Tharun-Reddy777/GDSReady-RV/docs/GDSReady_RV_Final_Project_Report.docx

GDSReady-RV

RTL-to-GDSII Implementation of a 32-bit 5-Stage Pipelined RISC-V Processor

Final Project Report
ASIC implementation using LibreLane and the SKY130 HD standard-cell flow

Design | riscv_core_asic
Architecture | 32-bit, 5-stage pipelined RISC-V
Pipeline | IF → ID → EX → MEM → WB
Clock target | 10.0 ns (100 MHz)
Final physical run | RISCV_ASIC_PNR_01

# 1. Abstract

This project implements a 32-bit RISC-V-style processor as a complete RTL-to-GDSII flow. The processor uses a five-stage IF/ID/EX/MEM/WB pipeline, a 32-entry register file, an ALU supporting the required arithmetic and logical operations, immediate generation, control and branch logic, forwarding, load-use hazard detection, instruction/data memory for RTL verification, and an ASIC-facing memory interface for physical implementation. The RTL was verified using directed regression tests for ALU operations, forwarding, load/store behavior, load-use hazards, BEQ/BNE, and JAL. The ASIC-facing core was synthesized and taken through floorplanning, placement, clock-tree synthesis, routing, post-route timing, DRC, LVS, antenna checking, and GDSII generation.

# 2. Objectives

- Develop a synthesizable 32-bit RISC-V processor with a five-stage pipeline.
- Implement register-file, ALU, immediate, control, branch, forwarding, and hazard-management logic.
- Verify representative RV32I-style instruction and pipeline behaviors using simulation.
- Create an ASIC-facing top-level interface for instruction and data memory.
- Complete synthesis and physical implementation using LibreLane/OpenROAD and SKY130 HD standard cells.
- Generate measurable implementation results including area, utilization, timing, DRC, LVS, antenna, and GDSII evidence.

# 3. Architecture

The processor follows the five-stage pipeline specified for the project: Instruction Fetch (IF), Instruction Decode (ID), Execute (EX), Memory Access (MEM), and Write Back (WB). Pipeline registers separate the stages: IF/ID, ID/EX, EX/MEM, and MEM/WB.

- Program counter and instruction-fetch path
- Instruction decoder and control unit
- Immediate generator
- 32 × 32-bit register file with x0 hard-wired to zero
- ALU supporting ADD, SUB, AND, OR, XOR, SLT, SLL, SRL, and SRA
- Branch/jump target and decision logic
- Forwarding unit for EX/MEM and MEM/WB dependencies
- Hazard detection for load-use dependencies
- Instruction and data memory for RTL simulation
- ASIC-facing instruction/data memory ports

# 4. Pipeline and Hazard Handling

## 4.1 Forwarding

The forwarding unit provides EX/MEM-to-EX and MEM/WB-to-EX operand forwarding. This permits dependent arithmetic instructions to execute without unnecessary pipeline stalls.

## 4.2 Load-use hazard

A load followed immediately by an instruction consuming the loaded register is detected by the hazard unit. The verified regression demonstrates the required stall behavior.

## 4.3 Branch and jump handling

BEQ and BNE branch decisions are supported by the branch unit. JAL generates the jump target and writes PC+4 to the destination register. Both branch behavior and JAL were explicitly verified.

# 5. RTL Module Structure

- alu.s
- register_file.s
- program_counter.s
- immediate_generator.s
- instruction_decoder.s
- control_unit.s
- branch_unit.s
- forwarding_unit.s
- hazard_detection.s
- instruction_memory.s
- data_memory.s
- if_id_reg.s
- id_ex_reg.s
- ex_mem_reg.s
- mem_wb_reg.s
- riscv_core.s
- riscv_core_asic.s

# 6. RTL Verification

The final directed RTL regression completed successfully. The simulation produced only the expected $readmemh short-file warnings because the test programs contain fewer than the 256 initialized memory words; these warnings did not cause test failures.

Test | Key results | Purpose | Result | Evidence
ALU + forwarding | x1=5, x2=10, x3=15, x4=0xFFFFFFFB, x5=10 | RAW dependencies and ALU | PASS | final_regression_results.txt
Load/store + load-use | x3=1, x4=9, memory[2]=1 | Memory path and load-use stall | PASS | final_regression_results.txt
BEQ/BNE | x3=7, x6=9 | Taken/not-taken branch behavior | PASS | final_regression_results.txt
JAL | x1=4, x2=7, x3=5 | Jump target and PC+4 writeback | PASS | final_regression_results.txt

Final RTL regression result: ALL RTL REGRESSION TESTS PASSED.

# 7. ASIC-Oriented RTL Architecture

The initial RTL top-level used internal instruction/data memories. For ASIC implementation, an explicit riscv_core_asic top-level was introduced with instruction-memory and data-memory interfaces. This avoids relying on behavioral memory arrays as the physical-design boundary and produces a real standard-cell implementation with external memory ports.

# 8. RTL-to-GDSII Flow

1. RTL elaboration and synthesis with Yosys through LibreLane
2. Floorplanning and standard-cell row generation
3. Placement
4. Clock-tree synthesis
5. Global and detailed routing
6. Post-route static timing analysis
7. Antenna checking and repair
8. Magic DRC
9. KLayout DRC
10. Netgen LVS
11. Final GDSII stream-out

# 9. Synthesis Results

Metric | RISCV_ASIC_SYNTH_02
Mapped standard-cell instances | 7,070
Mapped instance area | 86,360.3264
Unmapped instances | 0
Inferred latches | 0
Synthesis check errors | 0
Lint errors | 0
Lint warnings | 2

The synthesis run produced a full ASIC-facing mapped netlist. The netlist contains memory interface ports and thousands of mapped standard-cell instances, unlike the earlier internal-memory top-level attempt that optimized away most of the processor logic.

# 10. Physical Implementation Results

Metric | RISCV_ASIC_PNR_01
Clock target | 10.0 ns / 100 MHz
Post-P&R utilization | 47.3588%
Post-P&R aggregate setup WNS | −7.232224 ns
Post-P&R aggregate setup TNS | −1688.802674 ns
Hold WNS | 0 ns
Hold TNS | 0 ns
Worst nom_ss post-P&R setup WNS | −6.861401 ns

The final physical implementation is not setup-timing-clean at the 10 ns target under the slow-corner analysis. The worst post-P&R nominal slow-corner setup WNS is −6.861401 ns at 100 °C and 1.60 V. Hold timing is clean in the reported corners. The negative setup slack is retained as an implementation result rather than being presented as timing closure.

# 11. Physical Verification

Check | Result | Evidence
OpenROAD detailed-routing DRC | PASS / no final violations | riscv_core_asic.drc
Magic DRC | PASS | drc.magic.rpt
KLayout DRC | PASS; total = 0 | drc.klayout.json
Netgen LVS | PASS; circuits match uniquely | lvs.netgen.rpt
Antenna | PASS; no violating entries | antenna_summary.rpt

# 12. Final GDSII

The final physical implementation was streamed out as a GDSII database. The packaged deliverable is riscv_core_asic_final.gds. The final package also contains the corresponding LEF and DEF, synthesized netlist, timing reports, DRC reports, LVS report, antenna report, and metrics.

- final/gds/riscv_core_asic_final.gds
- final/layout/riscv_core_asic.lef
- final/layout/riscv_core_asic.def
- final/netlist/riscv_core_asic.nl.v

# 13. Implementation Iterations

Iteration | Configuration | Observed result | Decision
Initial synthesis | riscv_core with internal memories | CPU optimized away; floorplan had no standard-cell rows | Rejected
RISCV_SYNTH_02 | Debug outputs added to internal-memory top | 162 cells; incomplete CPU preserved | Rejected for P&R
RISCV_ASIC_SYNTH_02 | Explicit ASIC memory ports | 7,070 mapped cells; area 86,360.3264 | Used as synthesis baseline
RISCV_ASIC_PNR_01 | 40% floorplan utilization target | 47.36% final utilization; physical checks passed; −6.861 ns worst post-P&R setup WNS | Primary final run
RISCV_ASIC_PNR_02 | 35% floorplan utilization / 42% target density | Physical checks passed but setup WNS degraded to about −8.396 ns aggregate | Kept as experiment

# 14. Timing Investigation

The worst timing cone was traced to logic associated with the MEM/WB control and writeback path feeding the ID-stage register-file read/bypass network. The critical path investigation identified synthesized registers and deep combinational mux/logic cones between pipeline state and ID/EX register inputs. Several RTL restructuring experiments were evaluated, but changes that altered the verified register-file write-through behavior caused RTL regression failures. A cosmetic bypass-expression restructuring produced an identical synthesis result. The verified RTL was therefore restored and frozen before final reporting.

# 15. Limitations and Engineering Observations

- The final 10 ns target is not met for setup timing at the slow corner.
- Hold timing is clean in the reported signoff corners.
- The current implementation uses an ASIC-facing external memory interface rather than a compiled SRAM macro.
- The RTL regression uses behavioral memories for functional verification.
- The project evidence does not contain a reliable final power number; power is therefore not reported as a measured final metric.
- The implementation uses SKY130 HD standard cells and is an academic/open-source RTL-to-GDSII demonstration rather than a tapeout-qualified commercial ASIC.

# 16. Conclusion

The project demonstrates a complete RTL-to-GDSII implementation of a 32-bit five-stage pipelined RISC-V processor. Functional RTL verification passed all four final directed regression groups covering ALU/forwarding, load-store/load-use hazards, BEQ/BNE, and JAL. The ASIC-facing design was synthesized into a 7,070-cell mapped standard-cell netlist and successfully passed physical DRC, LVS, and antenna checks. A final GDSII database was generated together with LEF/DEF and signoff evidence. The principal remaining implementation limitation is setup timing at the 10 ns target under the slow corner, while hold timing remains clean.

# 17. Final Deliverables

- GDSII: final/gds/riscv_core_asic_final.gds
- LEF: final/layout/riscv_core_asic.lef
- DEF: final/layout/riscv_core_asic.def
- Synthesized netlist: final/netlist/riscv_core_asic.nl.v
- RTL sources: final/rtl/
- RTL regression: final/reports/final_regression_results.txt
- Synthesis metrics: final/reports/synthesis_metrics.csv
- P&R metrics: final/reports/metrics.csv and metrics.json
- Setup timing: final/reports/setup_nom_ss_max.rpt
- Hold timing: final/reports/hold_nom_ss_min.rpt
- Magic DRC: final/reports/drc.magic.rpt
- KLayout DRC: final/reports/drc.klayout.json
- LVS: final/reports/lvs.netgen.rpt
- Antenna: final/reports/antenna_summary.rpt

# Appendix A — Final RTL Regression Output

The archived regression reports PASS for all four directed tests. The simulator also reports expected $readmemh warnings because the hex files are shorter than the initialized 256-word memory range.

- ALU + FORWARDING: PASS
- LOAD/STORE + LOAD-USE: PASS
- BEQ/BNE: PASS
- JAL: PASS
- FINAL RTL REGRESSION RESULT: ALL RTL REGRESSION TESTS PASSED

GDSReady-RV — Final Project Report
