Tharun-Reddy777/GDSReady-RV/final/reports/metrics.csv

Metric | Value
design__lint_error__count | 0
design__lint_timing_construct__count | 0
design__lint_warning__count | 2
design__inferred_latch__count | 0
design__instance__count | 43749
design__instance__area | 214831
design__instance_unmapped__count | 0
synthesis__check_error__count | 0
design__max_slew_violation__count__corner:nom_tt_025C_1v80 | 0
design__max_fanout_violation__count__corner:nom_tt_025C_1v80 | 0
design__max_cap_violation__count__corner:nom_tt_025C_1v80 | 0
power__internal__total | 0.010249120183289051
power__switching__total | 0.004303347319364548
power__leakage__total | 2.23453341163804E-7
power__total | 0.014552691020071507
clock__skew__worst_hold__corner:nom_tt_025C_1v80 | -0.0630416292567756
clock__skew__worst_setup__corner:nom_tt_025C_1v80 | -0.0630416292567756
timing__hold__ws__corner:nom_tt_025C_1v80 | 0.428826430947068
timing__setup__ws__corner:nom_tt_025C_1v80 | 1.5069670382546227
timing__hold__tns__corner:nom_tt_025C_1v80 | 0.0
timing__setup__tns__corner:nom_tt_025C_1v80 | 0.0
timing__hold__wns__corner:nom_tt_025C_1v80 | 0
timing__setup__wns__corner:nom_tt_025C_1v80 | 0.0
timing__hold_vio__count__corner:nom_tt_025C_1v80 | 0
timing__hold_r2r__ws__corner:nom_tt_025C_1v80 | 0.428826
timing__hold_r2r_vio__count__corner:nom_tt_025C_1v80 | 0
timing__setup_vio__count__corner:nom_tt_025C_1v80 | 0
timing__setup_r2r__ws__corner:nom_tt_025C_1v80 | 1.506967
timing__setup_r2r_vio__count__corner:nom_tt_025C_1v80 | 0
design__max_slew_violation__count__corner:nom_ss_100C_1v60 | 898
design__max_fanout_violation__count__corner:nom_ss_100C_1v60 | 0
design__max_cap_violation__count__corner:nom_ss_100C_1v60 | 25
clock__skew__worst_hold__corner:nom_ss_100C_1v60 | -0.09535861259421492
clock__skew__worst_setup__corner:nom_ss_100C_1v60 | -0.09535861259421492
timing__hold__ws__corner:nom_ss_100C_1v60 | 0.9108406509060142
timing__setup__ws__corner:nom_ss_100C_1v60 | -6.861401419020496
timing__hold__tns__corner:nom_ss_100C_1v60 | 0.0
timing__setup__tns__corner:nom_ss_100C_1v60 | -1604.8350516070534
timing__hold__wns__corner:nom_ss_100C_1v60 | 0
timing__setup__wns__corner:nom_ss_100C_1v60 | -6.861401419020496
timing__hold_vio__count__corner:nom_ss_100C_1v60 | 0
timing__hold_r2r__ws__corner:nom_ss_100C_1v60 | 0.910841
timing__hold_r2r_vio__count__corner:nom_ss_100C_1v60 | 0
timing__setup_vio__count__corner:nom_ss_100C_1v60 | 269
timing__setup_r2r__ws__corner:nom_ss_100C_1v60 | -6.861402
timing__setup_r2r_vio__count__corner:nom_ss_100C_1v60 | 269
design__max_slew_violation__count__corner:nom_ff_n40C_1v95 | 0
design__max_fanout_violation__count__corner:nom_ff_n40C_1v95 | 0
design__max_cap_violation__count__corner:nom_ff_n40C_1v95 | 0
clock__skew__worst_hold__corner:nom_ff_n40C_1v95 | -0.04629896597155231
clock__skew__worst_setup__corner:nom_ff_n40C_1v95 | -0.04629896597155231
timing__hold__ws__corner:nom_ff_n40C_1v95 | 0.2646944405247403
timing__setup__ws__corner:nom_ff_n40C_1v95 | 4.796375876673759
timing__hold__tns__corner:nom_ff_n40C_1v95 | 0.0
timing__setup__tns__corner:nom_ff_n40C_1v95 | 0.0
timing__hold__wns__corner:nom_ff_n40C_1v95 | 0
timing__setup__wns__corner:nom_ff_n40C_1v95 | 0.0
timing__hold_vio__count__corner:nom_ff_n40C_1v95 | 0
timing__hold_r2r__ws__corner:nom_ff_n40C_1v95 | 0.264694
timing__hold_r2r_vio__count__corner:nom_ff_n40C_1v95 | 0
timing__setup_vio__count__corner:nom_ff_n40C_1v95 | 0
timing__setup_r2r__ws__corner:nom_ff_n40C_1v95 | 4.796376
timing__setup_r2r_vio__count__corner:nom_ff_n40C_1v95 | 0
design__max_slew_violation__count | 948
design__max_fanout_violation__count | 0
design__max_cap_violation__count | 26
clock__skew__worst_hold | -0.04073502761513319
clock__skew__worst_setup | -0.10748768845897598
timing__hold__ws | 0.26303782119169344
timing__setup__ws | -7.232223913338653
timing__hold__tns | 0.0
timing__setup__tns | -1688.8026743941152
timing__hold__wns | 0
timing__setup__wns | -7.232223913338653
timing__hold_vio__count | 0
timing__hold_r2r__ws | 0.263038
timing__hold_r2r_vio__count | 0
timing__setup_vio__count | 810
timing__setup_r2r__ws | -7.232224
timing__setup_r2r_vio__count | 810
design__die__bbox | 0.0 0.0 475.69 486.41
design__core__bbox | 5.52 10.88 470.12 473.28
design__io | 236
design__die__area | 231380
design__core__area | 214831
design__instance__count__stdcell | 11001
design__instance__area__stdcell | 101741
design__instance__count__macros | 0
design__instance__area__macros | 0
design__instance__count__padcells | 0
design__instance__area__padcells | 0
design__instance__count__cover | 0
design__instance__area__cover | 0
design__instance__utilization | 0.473588
design__instance__utilization__stdcell | 0.473588
design__rows | 170
design__rows:unithd | 170
design__sites | 171700
design__sites:unithd | 171700
design__instance__count__class:buffer | 32
design__instance__area__class:buffer | 160.154
design__instance__count__class:inverter | 61
design__instance__area__class:inverter | 246.486
design__instance__count__class:sequential_cell | 1477
design__instance__area__class:sequential_cell | 31461.4
design__instance__count__class:multi_input_combinational_cell | 5514
design__instance__area__class:multi_input_combinational_cell | 55793.5
flow__warnings__count | 1
flow__errors__count | 0
flow__warnings__count:ODB-0220 | 2
flow__warnings__type_count | 1
flow__warnings__count:ORD-0039 | 1
design__instance__count__class:fill_cell | 32748
design__instance__area__class:fill_cell | 113090
design__instance__count__class:tap_cell | 3010
design__instance__area__class:tap_cell | 3766.11
design__power_grid_violation__count__net:VGND | 0
design__power_grid_violation__count__net:VPWR | 0
design__power_grid_violation__count | 0
floorplan__design__io | 234
design__io__hpwl | 39716203
flow__warnings__count:GRT-0281 | 2
timing__drv__floating__nets | 2
timing__drv__floating__pins | 0
design__instance__displacement__total | 981.762
design__instance__displacement__mean | 0.086
design__instance__displacement__max | 9.082
route__wirelength__estimated | 265662
design__violations | 0
design__instance__count__class:timing_repair_buffer | 564
design__instance__area__class:timing_repair_buffer | 6447.43
flow__warnings__count:RSZ-0020 | 1
flow__warnings__count:STA-1140 | 6
design__instance__count__class:clock_buffer | 269
design__instance__area__class:clock_buffer | 3381.99
design__instance__count__class:clock_inverter | 39
design__instance__area__class:clock_inverter | 396.63
design__instance__count__setup_buffer | 174
design__instance__count__hold_buffer | 0
flow__warnings__count:RSZ-0062 | 1
global_route__vias | 781
global_route__wirelength | 520901
antenna__violating__nets | 0
antenna__violating__pins | 0
route__antenna_violation__count | 0
antenna_diodes_count | 13
design__instance__count__class:antenna_cell | 35
design__instance__area__class:antenna_cell | 87.584
route__net | 7889
route__net__special | 2
route__drc_errors__iter:0 | 713
route__wirelength__iter:0 | 370134
route__drc_errors__iter:1 | 116
route__wirelength__iter:1 | 369859
route__drc_errors__iter:2 | 68
route__wirelength__iter:2 | 369826
route__drc_errors__iter:3 | 0
route__wirelength__iter:3 | 369759
route__drc_errors__iter:4 | 2
route__wirelength__iter:4 | 369866
route__drc_errors__iter:5 | 2
route__wirelength__iter:5 | 369866
route__drc_errors__iter:6 | 0
route__wirelength__iter:6 | 369866
route__drc_errors | 0
route__wirelength | 369759
route__vias | 68986
route__vias__singlecut | 68986
route__vias__multicut | 0
flow__warnings__count:DRT-0120 | 18
flow__warnings__count:DRT-0349 | 10
design__disconnected_pin__count | 0
design__critical_disconnected_pin__count | 0
route__wirelength__max | 2356.21
timing__unannotated_net__count__corner:nom_tt_025C_1v80 | 133
timing__unannotated_net_filtered__count__corner:nom_tt_025C_1v80 | 0
timing__unannotated_net__count__corner:nom_ss_100C_1v60 | 133
timing__unannotated_net_filtered__count__corner:nom_ss_100C_1v60 | 0
timing__unannotated_net__count__corner:nom_ff_n40C_1v95 | 133
timing__unannotated_net_filtered__count__corner:nom_ff_n40C_1v95 | 0
design__max_slew_violation__count__corner:min_tt_025C_1v80 | 0
design__max_fanout_violation__count__corner:min_tt_025C_1v80 | 0
design__max_cap_violation__count__corner:min_tt_025C_1v80 | 0
clock__skew__worst_hold__corner:min_tt_025C_1v80 | -0.056258888029452885
clock__skew__worst_setup__corner:min_tt_025C_1v80 | -0.056258888029452885
timing__hold__ws__corner:min_tt_025C_1v80 | 0.43187654674888387
timing__setup__ws__corner:min_tt_025C_1v80 | 1.7078632325099068
timing__hold__tns__corner:min_tt_025C_1v80 | 0.0
timing__setup__tns__corner:min_tt_025C_1v80 | 0.0
timing__hold__wns__corner:min_tt_025C_1v80 | 0
timing__setup__wns__corner:min_tt_025C_1v80 | 0.0
timing__hold_vio__count__corner:min_tt_025C_1v80 | 0
timing__hold_r2r__ws__corner:min_tt_025C_1v80 | 0.431877
timing__hold_r2r_vio__count__corner:min_tt_025C_1v80 | 0
timing__setup_vio__count__corner:min_tt_025C_1v80 | 0
timing__setup_r2r__ws__corner:min_tt_025C_1v80 | 1.707863
timing__setup_r2r_vio__count__corner:min_tt_025C_1v80 | 0
timing__unannotated_net__count__corner:min_tt_025C_1v80 | 133
timing__unannotated_net_filtered__count__corner:min_tt_025C_1v80 | 0
design__max_slew_violation__count__corner:min_ss_100C_1v60 | 782
design__max_fanout_violation__count__corner:min_ss_100C_1v60 | 0
design__max_cap_violation__count__corner:min_ss_100C_1v60 | 20
clock__skew__worst_hold__corner:min_ss_100C_1v60 | -0.08620027158276397
clock__skew__worst_setup__corner:min_ss_100C_1v60 | -0.08620027158276397
timing__hold__ws__corner:min_ss_100C_1v60 | 0.9148640992610466
timing__setup__ws__corner:min_ss_100C_1v60 | -6.468038732129711
timing__hold__tns__corner:min_ss_100C_1v60 | 0.0
timing__setup__tns__corner:min_ss_100C_1v60 | -1516.1579514341806
timing__hold__wns__corner:min_ss_100C_1v60 | 0
timing__setup__wns__corner:min_ss_100C_1v60 | -6.468038732129711
timing__hold_vio__count__corner:min_ss_100C_1v60 | 0
timing__hold_r2r__ws__corner:min_ss_100C_1v60 | 0.914864
timing__hold_r2r_vio__count__corner:min_ss_100C_1v60 | 0
timing__setup_vio__count__corner:min_ss_100C_1v60 | 269
timing__setup_r2r__ws__corner:min_ss_100C_1v60 | -6.468039
timing__setup_r2r_vio__count__corner:min_ss_100C_1v60 | 269
timing__unannotated_net__count__corner:min_ss_100C_1v60 | 133
timing__unannotated_net_filtered__count__corner:min_ss_100C_1v60 | 0
design__max_slew_violation__count__corner:min_ff_n40C_1v95 | 0
design__max_fanout_violation__count__corner:min_ff_n40C_1v95 | 0
design__max_cap_violation__count__corner:min_ff_n40C_1v95 | 0
clock__skew__worst_hold__corner:min_ff_n40C_1v95 | -0.04073502761513319
clock__skew__worst_setup__corner:min_ff_n40C_1v95 | -0.04073502761513319
timing__hold__ws__corner:min_ff_n40C_1v95 | 0.266485119291802
timing__setup__ws__corner:min_ff_n40C_1v95 | 4.914443657789731
timing__hold__tns__corner:min_ff_n40C_1v95 | 0.0
timing__setup__tns__corner:min_ff_n40C_1v95 | 0.0
timing__hold__wns__corner:min_ff_n40C_1v95 | 0
timing__setup__wns__corner:min_ff_n40C_1v95 | 0.0
timing__hold_vio__count__corner:min_ff_n40C_1v95 | 0
timing__hold_r2r__ws__corner:min_ff_n40C_1v95 | 0.266485
timing__hold_r2r_vio__count__corner:min_ff_n40C_1v95 | 0
timing__setup_vio__count__corner:min_ff_n40C_1v95 | 0
timing__setup_r2r__ws__corner:min_ff_n40C_1v95 | 4.914443
timing__setup_r2r_vio__count__corner:min_ff_n40C_1v95 | 0
timing__unannotated_net__count__corner:min_ff_n40C_1v95 | 133
timing__unannotated_net_filtered__count__corner:min_ff_n40C_1v95 | 0
design__max_slew_violation__count__corner:max_tt_025C_1v80 | 0
design__max_fanout_violation__count__corner:max_tt_025C_1v80 | 0
design__max_cap_violation__count__corner:max_tt_025C_1v80 | 0
clock__skew__worst_hold__corner:max_tt_025C_1v80 | -0.07248191141330396
clock__skew__worst_setup__corner:max_tt_025C_1v80 | -0.07248191141330396
timing__hold__ws__corner:max_tt_025C_1v80 | 0.4261922602131917
timing__setup__ws__corner:max_tt_025C_1v80 | 1.3148957850270655
timing__hold__tns__corner:max_tt_025C_1v80 | 0.0
timing__setup__tns__corner:max_tt_025C_1v80 | 0.0
timing__hold__wns__corner:max_tt_025C_1v80 | 0
timing__setup__wns__corner:max_tt_025C_1v80 | 0.0
timing__hold_vio__count__corner:max_tt_025C_1v80 | 0
timing__hold_r2r__ws__corner:max_tt_025C_1v80 | 0.426192
timing__hold_r2r_vio__count__corner:max_tt_025C_1v80 | 0
timing__setup_vio__count__corner:max_tt_025C_1v80 | 0
timing__setup_r2r__ws__corner:max_tt_025C_1v80 | 1.314896
timing__setup_r2r_vio__count__corner:max_tt_025C_1v80 | 0
timing__unannotated_net__count__corner:max_tt_025C_1v80 | 133
timing__unannotated_net_filtered__count__corner:max_tt_025C_1v80 | 0
design__max_slew_violation__count__corner:max_ss_100C_1v60 | 948
design__max_fanout_violation__count__corner:max_ss_100C_1v60 | 0
design__max_cap_violation__count__corner:max_ss_100C_1v60 | 26
clock__skew__worst_hold__corner:max_ss_100C_1v60 | -0.10748768845897598
clock__skew__worst_setup__corner:max_ss_100C_1v60 | -0.10748768845897598
timing__hold__ws__corner:max_ss_100C_1v60 | 0.9067367113794199
timing__setup__ws__corner:max_ss_100C_1v60 | -7.232223913338653
timing__hold__tns__corner:max_ss_100C_1v60 | 0.0
timing__setup__tns__corner:max_ss_100C_1v60 | -1688.8026743941152
timing__hold__wns__corner:max_ss_100C_1v60 | 0
timing__setup__wns__corner:max_ss_100C_1v60 | -7.232223913338653
timing__hold_vio__count__corner:max_ss_100C_1v60 | 0
timing__hold_r2r__ws__corner:max_ss_100C_1v60 | 0.906737
timing__hold_r2r_vio__count__corner:max_ss_100C_1v60 | 0
timing__setup_vio__count__corner:max_ss_100C_1v60 | 272
timing__setup_r2r__ws__corner:max_ss_100C_1v60 | -7.232224
timing__setup_r2r_vio__count__corner:max_ss_100C_1v60 | 272
timing__unannotated_net__count__corner:max_ss_100C_1v60 | 133
timing__unannotated_net_filtered__count__corner:max_ss_100C_1v60 | 0
design__max_slew_violation__count__corner:max_ff_n40C_1v95 | 0
design__max_fanout_violation__count__corner:max_ff_n40C_1v95 | 0
design__max_cap_violation__count__corner:max_ff_n40C_1v95 | 0
clock__skew__worst_hold__corner:max_ff_n40C_1v95 | -0.054423911362455744
clock__skew__worst_setup__corner:max_ff_n40C_1v95 | -0.054423911362455744
timing__hold__ws__corner:max_ff_n40C_1v95 | 0.26303782119169344
timing__setup__ws__corner:max_ff_n40C_1v95 | 4.6635141512916505
timing__hold__tns__corner:max_ff_n40C_1v95 | 0.0
timing__setup__tns__corner:max_ff_n40C_1v95 | 0.0
timing__hold__wns__corner:max_ff_n40C_1v95 | 0
timing__setup__wns__corner:max_ff_n40C_1v95 | 0.0
timing__hold_vio__count__corner:max_ff_n40C_1v95 | 0
timing__hold_r2r__ws__corner:max_ff_n40C_1v95 | 0.263038
timing__hold_r2r_vio__count__corner:max_ff_n40C_1v95 | 0
timing__setup_vio__count__corner:max_ff_n40C_1v95 | 0
timing__setup_r2r__ws__corner:max_ff_n40C_1v95 | 4.663514
timing__setup_r2r_vio__count__corner:max_ff_n40C_1v95 | 0
timing__unannotated_net__count__corner:max_ff_n40C_1v95 | 133
timing__unannotated_net_filtered__count__corner:max_ff_n40C_1v95 | 0
timing__unannotated_net__count | 133
timing__unannotated_net_filtered__count | 0
design_powergrid__voltage__worst__net:VPWR__corner:nom_tt_025C_1v80 | 1.79811
design_powergrid__drop__average__net:VPWR__corner:nom_tt_025C_1v80 | 1.7998
design_powergrid__drop__worst__net:VPWR__corner:nom_tt_025C_1v80 | 0.00188755
design_powergrid__voltage__worst__net:VGND__corner:nom_tt_025C_1v80 | 0.00120196
design_powergrid__drop__average__net:VGND__corner:nom_tt_025C_1v80 | 0.000191708
design_powergrid__drop__worst__net:VGND__corner:nom_tt_025C_1v80 | 0.00120196
design_powergrid__voltage__worst | 0.00120196
design_powergrid__voltage__worst__net:VPWR | 1.79811
design_powergrid__drop__worst | 0.00188755
design_powergrid__drop__worst__net:VPWR | 0.00188755
design_powergrid__voltage__worst__net:VGND | 0.00120196
design_powergrid__drop__worst__net:VGND | 0.00120196
ir__voltage__worst | 1.8000000000000000444089209850062616169452667236328125
ir__drop__avg | 0.0001990000000000000123824561715224490399123169481754302978515625
ir__drop__worst | 0.00188999999999999996995458939608170112478546798229217529296875
design__xor_difference__count | 0
magic__drc_error__count | 0
klayout__drc_error__count | 0
magic__illegal_overlap__count | 0
design__lvs_device_difference__count | 0
design__lvs_net_difference__count | 0
design__lvs_property_fail__count | 0
design__lvs_error__count | 0
design__lvs_unmatched_device__count | 0
design__lvs_unmatched_net__count | 0
design__lvs_unmatched_pin__count | 0
